cocktailmixer/electronics/controllerboard/README.md

# Controllerboard
### What is the status?
- design v01: work in progress
- schematic v01: work in progress
- layout v01: todo
- gerbers and bom: todo
- testing: todo
### What does it do?
todo
