cocktailmixer/electronics/driverboard/driverboard.kicad_pcb

## KiCad design driverboard/driverboard.kicad_pcb (2019-10-16)

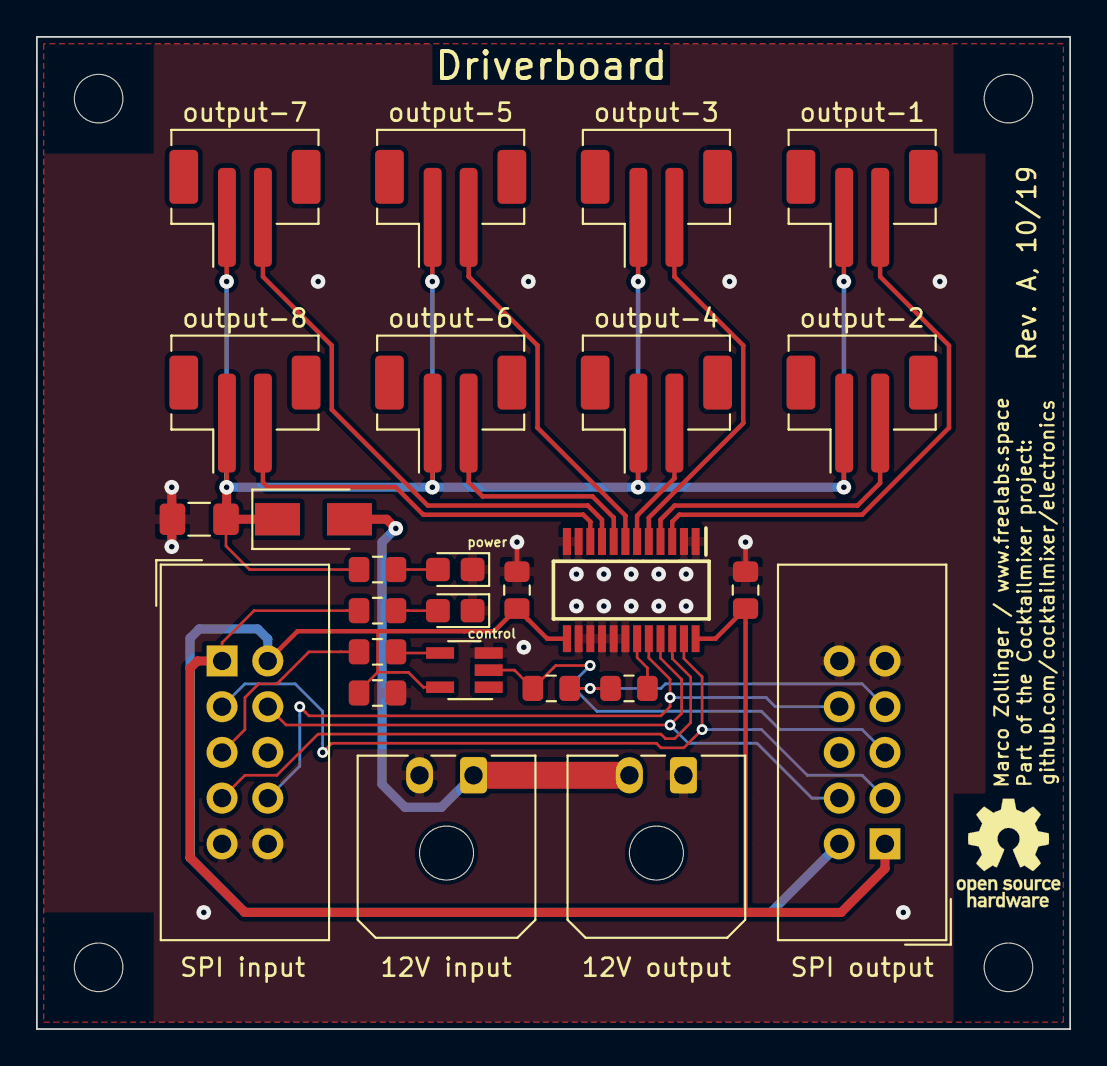
[picture p1: board driverboard.kicad_pcb from above]

Board: 2 copper layers, 57.4 x 55.1 mm, 30 parts (0 on the bottom side), 24 nets.

Parts:
C1, C2, C3: 100n; C_0805_2012Metric_Pad1.15x1.40mm_HandSolder
C4: 10u; C_1206_3216Metric_Pad1.42x1.75mm_HandSolder
D1: power; LED_0805_2012Metric_Castellated
D2: control; LED_0805_2012Metric_Castellated
D3: MBRA340; D_SMA
IC1: NCV7240ADPR2G; SOP65P600X175-24N
J1: output-1; JST_PH_B2B-PH-SM4-TB_1x02-1MP_P2.00mm_Vertical
J2: output-2; JST_PH_B2B-PH-SM4-TB_1x02-1MP_P2.00mm_Vertical
J3: output-3; JST_PH_B2B-PH-SM4-TB_1x02-1MP_P2.00mm_Vertical
J4: output-4; JST_PH_B2B-PH-SM4-TB_1x02-1MP_P2.00mm_Vertical
J5: output-5; JST_PH_B2B-PH-SM4-TB_1x02-1MP_P2.00mm_Vertical
J6: output-6; JST_PH_B2B-PH-SM4-TB_1x02-1MP_P2.00mm_Vertical
J7: output-7; JST_PH_B2B-PH-SM4-TB_1x02-1MP_P2.00mm_Vertical
J8: output-8; JST_PH_B2B-PH-SM4-TB_1x02-1MP_P2.00mm_Vertical
J9: SPI input; IDC-Header_2x05_P2.54mm_Vertical
J10: SPI output; IDC-Header_2x05_P2.54mm_Vertical
J11: 12V input; Molex_Micro-Fit_3.0_43650-0200_1x02_P3.00mm_Horizontal
J12: 12V output; Molex_Micro-Fit_3.0_43650-0200_1x02_P3.00mm_Horizontal
MH1, MH2, MH3, MH4: MountingHole_2.7mm_M2.5
R1, R3: 100; R_0805_2012Metric_Pad1.15x1.40mm_HandSolder
R2, R4: 2k0; R_0805_2012Metric_Pad1.15x1.40mm_HandSolder
R5: 560; R_0805_2012Metric_Pad1.15x1.40mm_HandSolder
U1: 74LVC1G34; SOT-23-5_HandSoldering

Connections:
+5V: C1.1, IC1.24, J9.1, J10.1, R5.1
+12V: C4.1, D3.1, J1.1, J2.1, J3.1, J4.1, J5.1, J6.1, J7.1, J8.1, R4.1
GND: C1.2, C2.2, C3.2, C4.2, D1.1, D2.1, IC1.1, IC1.2, IC1.11, IC1.12, IC1.14, IC1.15, IC1.16, IC1.17, IC1.18, J9.9, J9.10, J10.9, J10.10, J11.2, J12.1, U1.3
unnamed: D1.2, R4.2
unnamed: D2.2, R5.2
unnamed: D3.2, J11.1, J12.2
unnamed: IC1.3, J1.2
unnamed: IC1.4, J2.2
unnamed: IC1.5, J3.2
unnamed: IC1.6, J4.2
unnamed: IC1.7, J5.2
unnamed: IC1.8, J6.2
unnamed: IC1.9, J7.2
unnamed: IC1.10, J8.2
unnamed: IC1.19, R1.2
unnamed: IC1.20, J9.8, J10.8
unnamed: IC1.21, J9.4, J10.4
unnamed: IC1.22, J9.7
unnamed: IC1.23, J9.3, J10.3
unnamed: J9.5, R3.2
unnamed: J10.5, R2.2, U1.2
unnamed: J10.7, R1.1, R2.1
unnamed: R3.1, U1.4
VCC: C2.1, C3.1, IC1.13, J9.2, J10.2, U1.5
