cocktailmixer/electronics/(commit log)

2019-07-12 driverboard initial commit
    [driverboard.kicad_pcb, driverboard.sch]
2019-07-13 add driver and valve connectors
    [driverboard.sch]
2019-07-13 wire data input/output connectors
    [driverboard.sch]
2019-07-13 improved readability
    [driverboard.sch]
2019-07-13 schematic wiring complete w/o buffers
    [driverboard.sch]
2019-07-13 added daisy-chain auto-termination
    [driverboard.sch]
2019-07-14 finalize v01 design
    [driverboard.sch]
2019-07-23 add optional crystal oscillator
    [controllerboard.sch]
2019-07-23 add analog AVR supply and raspi header
    [controllerboard.sch]
2019-07-24 add raspi isp and uart bus
    [controllerboard.sch]
2019-07-25 add spi multiplexer and reset circuitry
    [controllerboard.sch]
2019-07-27 add 5v buck converter draft
    [controllerboard.sch]
2019-07-29 add power switch, gate driver and current sense
    [controllerboard.sch]
2019-07-30 add emergency switch logic
    [controllerboard.sch]
2019-09-02 remove MUX and use soft-SPI for driverboard
    [controllerboard.sch]
2019-09-02 add emergency shutdown circuitry
    [controllerboard.sch]
2019-09-04 complete emergency shutdown circuitry
    [controllerboard.sch]
2019-09-04 add I2C circuitry
    [controllerboard.sch]
2019-09-04 add driverboard interface
    [controllerboard.sch]
2019-09-06 minor and cosmetic improvements
    [controllerboard.sch]
2019-10-07 add driverboard component libraries
2019-10-08 assign driverboard footprints
    [driverboard.sch]
2019-10-08 add design rules, start placement
    [driverboard.kicad_pcb]
2019-10-08 route output traces
    [driverboard.kicad_pcb]
2019-10-08 start routing data connectors
    [driverboard.kicad_pcb]
2019-10-08 finish routing signals
    [driverboard.kicad_pcb]
2019-10-08 add ground polygon fill
    [driverboard.kicad_pcb]
2019-10-11 correct output power connector polarity
    [driverboard.sch]
2019-10-11 finish routing
    [driverboard.kicad_pcb, driverboard.sch]
2019-10-11 improve routing
    [driverboard.kicad_pcb]
2019-10-13 add reverse polarity protection
    [driverboard.kicad_pcb, driverboard.sch]
2019-10-14 add mounting holes
    [driverboard.kicad_pcb]
2019-10-15 add labels
    [driverboard.kicad_pcb, driverboard.sch]
