cocktailmixer/electronics/(notices)

Notices in the files:
driverboard/driverboard.sch:
https://creativecommons.org/licenses/by-sa/4.0
License: CC BY-SA 4.0
